AurelienBernardP/Bioelectronics-ECG-design/LTspice-ECG-model.asc

C1: cap; 47n
C2: cap; 47n
C3: cap; 47n
C4: cap; 100p
C5: cap; 100p
C6: cap; 100p
C7: cap; 100p
C8: cap; 100p
C9: cap; 330p
C10: cap; 1n
C11: cap; 1.1µ
C12: cap; 9.91n
C13: cap; 9.91n
C14: cap; 20.01n
C15: cap; 600p
C16: cap; 2.1n
C17: cap; 100n
C18: cap; 100n
R1: res; 52k
R2: res; 52k
R3: res; 52k
R4: res; 150.9k
R5: res; 150.9k
R6: res; 150.9k
R7: res; 150.9k
R8: res; 500k
R9: res; 10k
R10: res; 10k
R11: res; 270
R12: res; 270
R13: res; 2.82Meg
R14: res; 333.5k
R15: res; 333.5k
R16: res; 150.6k
R17: res; 150k
R18: res; 5.59k
U1: ADTL084
U2: ADTL084
U3: LT1167
U4: ADTL084
U5: ADTL084
V1: voltage; 300m
V2: voltage; 300m
V3: voltage; 300m
V4: voltage; SINE(0 300 100)
V5: voltage; 10
V6: voltage; 10
V7: voltage; PWL REPEAT FOREVER file=ECG-LTSPICE.txt ENDREPEAT; AC 0.5
V8: voltage; ""; AC 0
V50Hz: voltage; SINE(0 300 50)
Named nets: 0, VDD, VSS, Vout
.ac dec 100000 0.00011hz 10000hz
